tantapat0490/Solar-Compost-Mixer-499/assets/0506f52b-0901-403b-ad17-29e4039f05b9.jpg

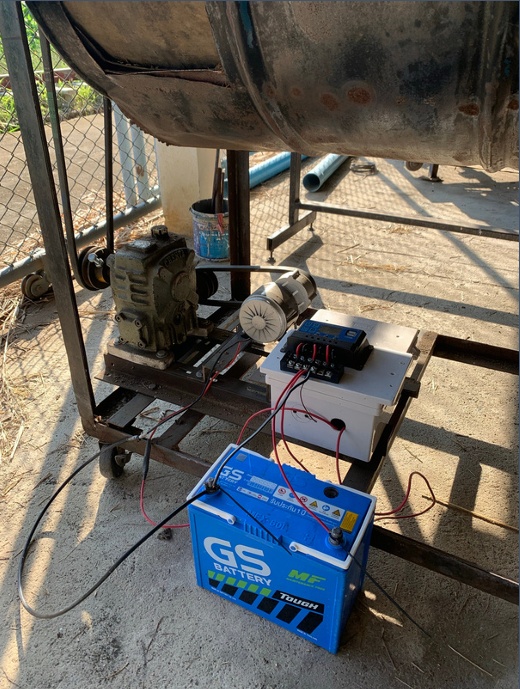
assets/0506f52b-0901-403b-ad17-29e4039f05b9.jpg
