tantapat0490/Solar-Compost-Mixer-499/assets/ADC Average.drawio.png

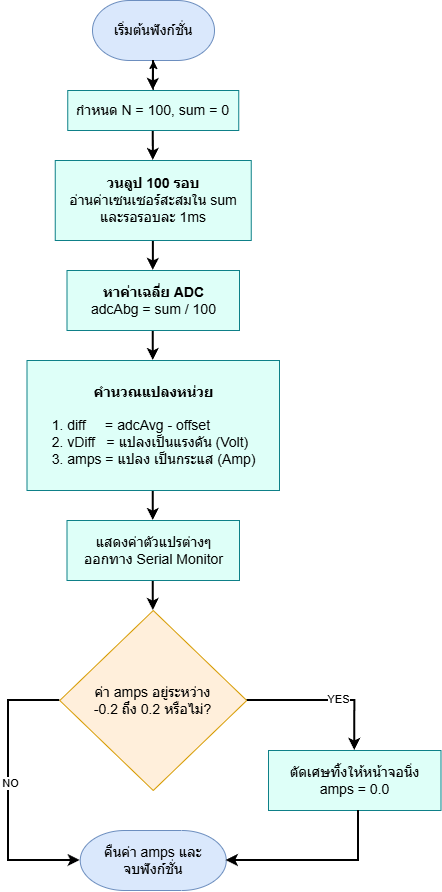
assets/ADC Average.drawio.png
