tantapat0490/Solar-Compost-Mixer-499/assets/IMG_8146.JPG

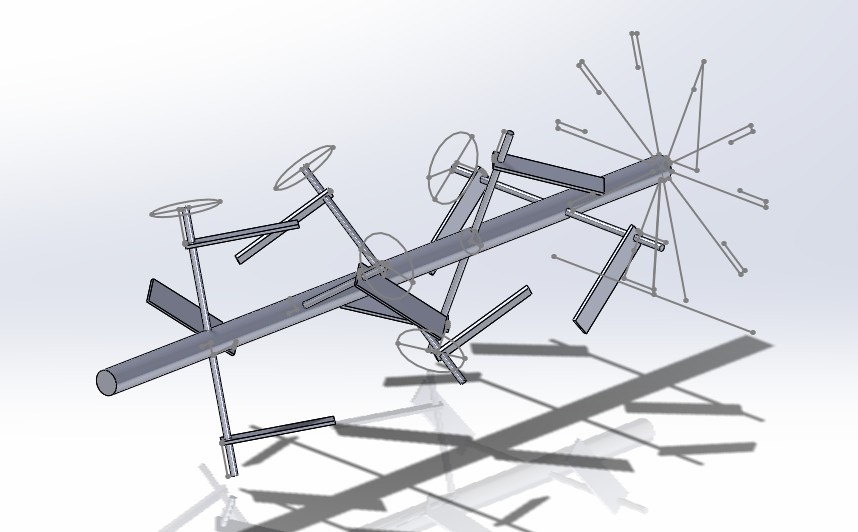
assets/IMG_8146.JPG
