tantapat0490/Solar-Compost-Mixer-499/assets/IMG_8149.JPG

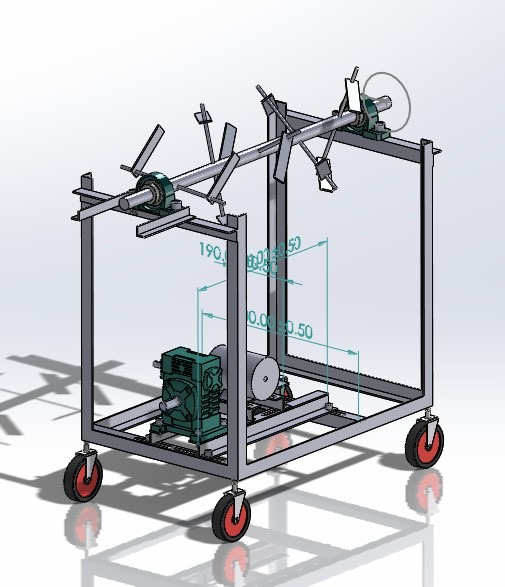
assets/IMG_8149.JPG
