tantapat0490/Solar-Compost-Mixer-499/assets/OverCurrent Protection Loop.drawio.png

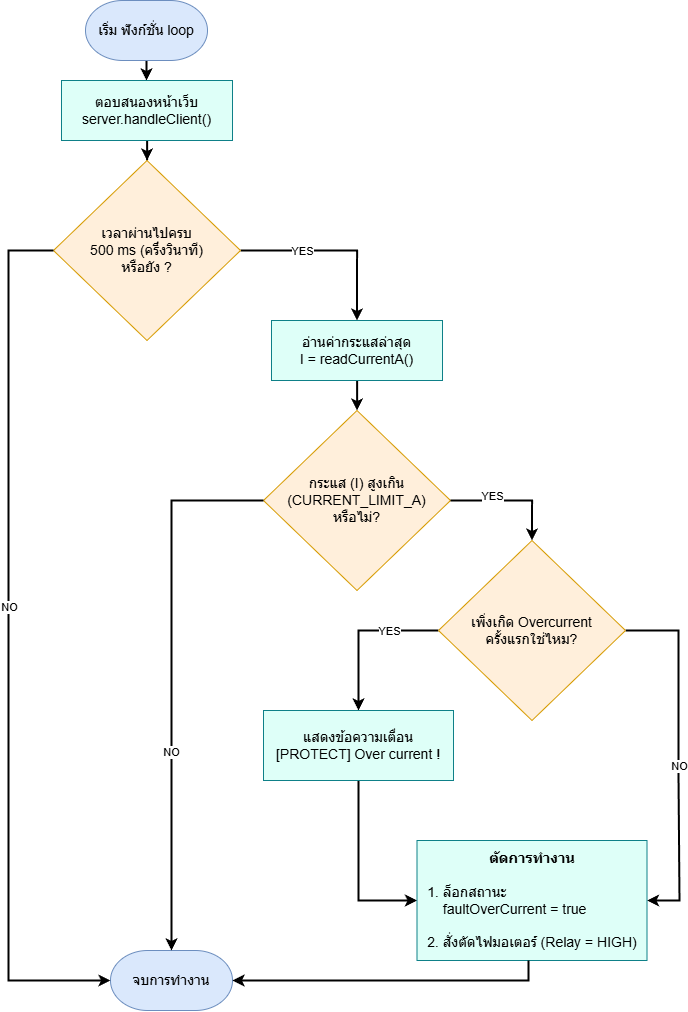
assets/OverCurrent Protection Loop.drawio.png
