tantapat0490/Solar-Compost-Mixer-499/assets/Project_KU_photo_2025-Sep-24_092.jpg

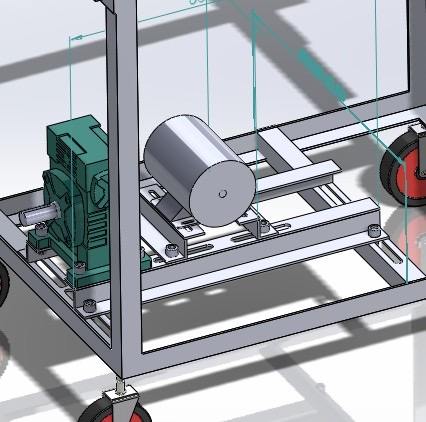
assets/Project_KU_photo_2025-Sep-24_092.jpg
