tantapat0490/Solar-Compost-Mixer-499/assets/Project_KU_video_2025-Sep-24_205-ezgif.com-video-to-gif-converter (1).gif

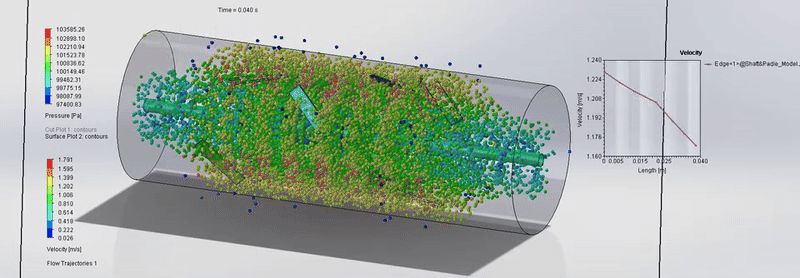
assets/Project_KU_video_2025-Sep-24_205-ezgif.com-video-to-gif-converter (1).gif
