tantapat0490/Solar-Compost-Mixer-499/assets/WIFI_STA.drawio.png

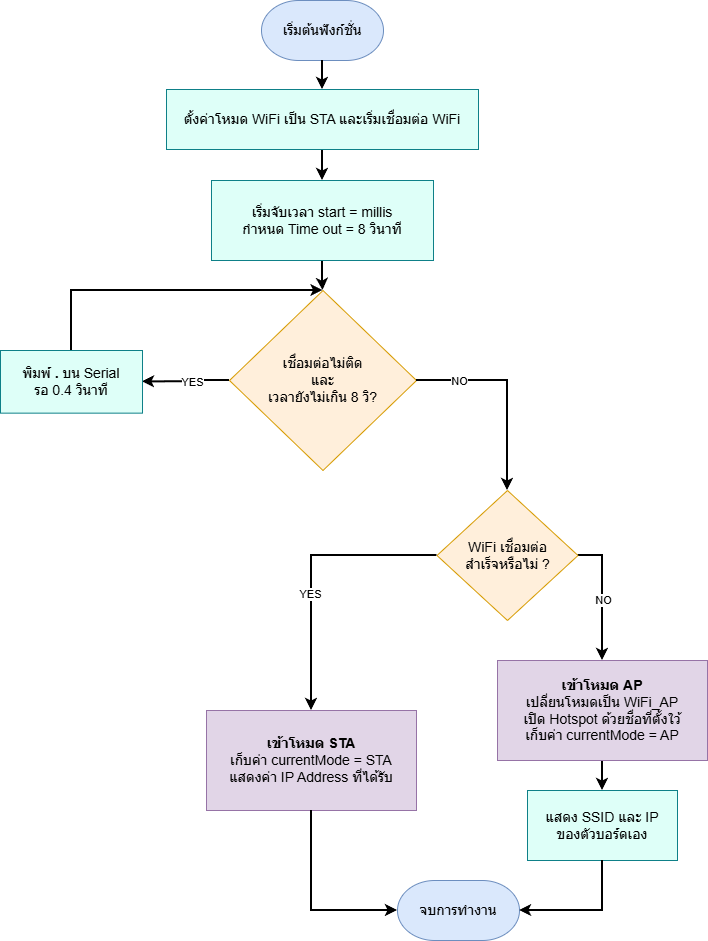
assets/WIFI_STA.drawio.png
